georgc4/ecig-dfd-deliverable/main.tex

\documentclass[11pt]{article}
\input{preamble}

\begin{document}

% ============================================================
% COVER PAGE
% ============================================================
\begin{titlepage}
\centering
\vspace*{2cm}

{\Large\textbf{MECE E4612 --- Sustainable Manufacturing}}\\[0.5cm]
{\large Columbia University, Department of Mechanical Engineering}\\[2cm]

{\LARGE\textbf{Design for Disassembly of Disposable\\[0.3cm]
Electronic Cigarettes: A Universal Standard\\[0.3cm]
for Battery Recovery}}\\[3cm]

{\large
{Aaron Li}\\[4pt]
{Carlos Georges}\\[4pt]
{Noah Thomas}\\[4pt]
{Tony Del Vecchio}\\[2cm]
}

\authorlegend

\vfill
{\large \today}
\end{titlepage}

% ============================================================
% TABLE OF CONTENTS
% ============================================================
\tableofcontents
\newpage

% ============================================================
% REPORT BODY
% ============================================================
\input{sections/01_introduction}
\input{sections/02_materials_processes}
\input{sections/03_dfd_analysis}
\input{sections/04_lca}
\input{sections/05_alternative_concept}
\input{sections/06_results}
\input{sections/07_conclusions}

% ============================================================
% REFERENCES
% ============================================================
\newpage
\bibliographystyle{plainnat}
\bibliography{references}

\end{document}
