georgc4/ecig-dfd-deliverable/slides/outline.md

# Presentation Outline: E-Cigarette Design for Disassembly

**Constraints**: 12 slides max, 10-minute time slot + Q&A
**Tip**: ~50 seconds per slide average. Practice beforehand.

---

## Slide 1: Title Slide (~10 sec)
**Speaker**: All (introduce yourselves)

- **Title**: Design for Disassembly of Disposable Electronic Cigarettes: A Universal Standard for Battery Recovery
- **Course**: MECE E4612 — Sustainable Manufacturing
- **Team**: [Names]
- **Date**: [Presentation date]

---

## Slide 2: The E-Waste Crisis (~60 sec)
**Speaker**: Member A

**Key stats** (use large numbers, impactful visuals):
- 840 million disposable vapes discarded globally per year (5.7 per second)
- 30 tons of lithium wasted annually — enough for 3,350 EV batteries
- Batteries capable of 450+ charge cycles, used exactly once
- $95M/year in waste facility fires from lithium batteries
- 52.9% of young users throw vapes in regular trash

**Visual**: Infographic or striking photo of vape waste pile. Consider a split image: landfill of vapes vs. EV batteries that could have been made.

---

## Slide 3: Our Product (~50 sec)
**Speaker**: Member A

- Photo of the selected e-cigarette (full device)
- Brand, model, retail price, puff count
- Why this product was chosen:
  - Meets all requirements (5+ parts, 3+ materials, 2+ metals, <$20)
  - Representative of the most common disposable vape form factor
- Brief functional description (1-2 sentences)

**Visual**: High-quality product photo, front/back/side.

---

## Slide 4: Disassembly & Parts (~60 sec)
**Speaker**: Member B

- Step-by-step disassembly photos (3-4 key stages)
- Note: disassembly was destructive (cutting/prying required)
- Labeled exploded view or parts laid out on table
- Parts inventory table (7 parts with materials)

**Visual**: Photo of all parts laid out, labeled. Consider before/after disassembly comparison.

---

## Slide 5: Materials Analysis (~50 sec)
**Speaker**: Member B

- Material identification results (how each was tested)
  - Burn test, scratch test, magnet test, density, visual
- Highlight the two metallic materials: aluminum (housing) + kanthal/nichrome (coil)
- Additional metals: copper (PCB), cobalt/nickel/lithium (battery)
- Weight breakdown by part

**Visual**: Close-up photos of material tests. Table of materials + weights.

---

## Slide 6: Manufacturing Processes (~50 sec)
**Speaker**: Member B

- Focus on the 3 multi-process parts:
  1. Battery: electrode coating → cell winding → welding → wrapping
  2. Housing: extrusion → anodizing → pad printing
  3. PCB: etching → drilling → SMT → reflow solder
- Highlight that current design uses permanent joining (ultrasonic welding / adhesives)

**Visual**: Process flow diagram for each multi-process part. Simple icons or photos.

---

## Slide 7: DfD Principles Applied (~60 sec)
**Speaker**: Member C

- Top 5 DfD principles most relevant:
  1. Reversible fasteners (snap-fits replace welding)
  2. Modular architecture (3 separable modules)
  3. Hazardous components most accessible (battery first out)
  4. Material marking (ISO codes, QR for recycling)
  5. Minimize disassembly steps (1 step for battery, <5 total)
- For each: how current design VIOLATES the principle

**Visual**: Two-column layout — "Current" vs. "DfD Redesign" for each principle. Icons or simple diagrams.

---

## Slide 8: LCA — Reference Product (~50 sec)
**Speaker**: Member C

- LCA methodology summary (software, database, functional unit)
- Key results for reference product:
  - Dominant impact category
  - Dominant life cycle stage
  - Dominant SBOM input (likely battery materials)
- Stacked bar chart by life cycle stage

**Visual**: LCA results chart (stacked bar or pie by stage). Keep it clean, highlight the biggest contributor.

---

## Slide 9: The Removable Battery Standard (~60 sec)
**Speaker**: Member D

**This is the centerpiece slide — the main contribution.**

- Three standardized battery sizes (S/M/L) covering full market range
- Snap-fit battery compartment at device base
- Spring-loaded contacts, keyed orientation
- Color-coded size identification + QR code
- 1-step, tool-free battery removal
- Modular device: battery + atomizer cartridge + body

**Visual**: Exploded view CAD render or detailed diagram. Side-by-side: sealed current design vs. open DfD design with removable battery.

---

## Slide 10: LCA — DfD vs. Reference (~50 sec)
**Speaker**: Member D

- Side-by-side LCA comparison: Reference vs. DfD vs. Alternative concept
- Highlight % reduction in key impact categories
- Show effect of battery reuse (10-450 cycles) on per-device impact
- Material recovery rates: ~0% → >90%

**Visual**: Grouped bar chart comparing 3 concepts across impact categories. Use color consistently.

---

## Slide 11: Results & Discussion (~50 sec)
**Speaker**: Member D

- Disassembly time: X minutes → <30 seconds
- Material recovery: ~0% → >90%
- Fire risk: eliminated (batteries separated before disposal)
- Cost: marginal manufacturing increase offset by battery reuse savings
- Regulatory alignment: meets EU Batteries Regulation 2027 ahead of deadline
- Barriers: manufacturer adoption, consumer behavior, standardization governance

**Visual**: Summary table or dashboard-style layout with key metrics.

---

## Slide 12: Conclusions & Q&A (~30 sec + Q&A)
**Speaker**: All

- 3 key takeaways:
  1. Current disposable e-cig design is antithetical to sustainability
  2. DfD principles enable dramatic improvements with minimal design changes
  3. A universal battery standard is technically feasible and regulatory-aligned
- The EU Batteries Regulation (Feb 2027) makes this inevitable — the question is who leads
- Open for questions

**Visual**: Clean slide with 3 bullet points and "Questions?" at the bottom.

---

## General Presentation Tips

- **Font size**: Minimum 24pt for body text, 36pt+ for titles
- **Photos**: Use your OWN disassembly photos — they demonstrate hands-on work
- **Timing**: Practice to fit in 10 minutes. Each slide ~50 seconds.
- **Transitions**: Smooth handoffs between speakers. Each person covers 3 slides.
- **Member distribution**:
  - Member A: Slides 2-3 (problem + product)
  - Member B: Slides 4-6 (disassembly + materials + processes)
  - Member C: Slides 7-8 (DfD principles + reference LCA)
  - Member D: Slides 9-11 (standard + comparison LCA + results)
  - All: Slides 1, 12 (title + conclusions)
