georgc4/ecig-dfd-deliverable/figures/snapfit_cross_section.png

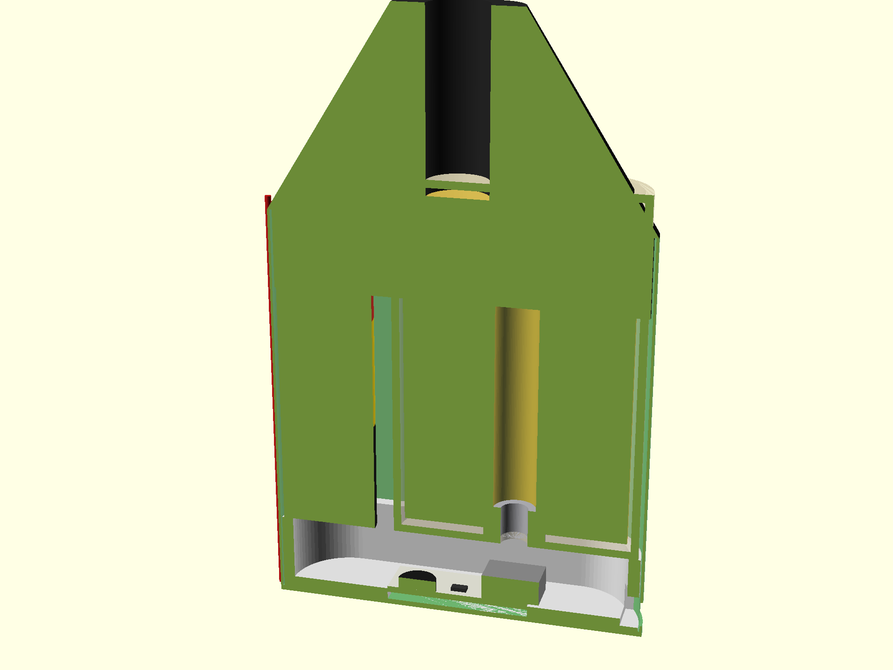
figures/snapfit_cross_section.png
