georgc4/ecig-dfd-deliverable/figures/snapfit_exploded.png

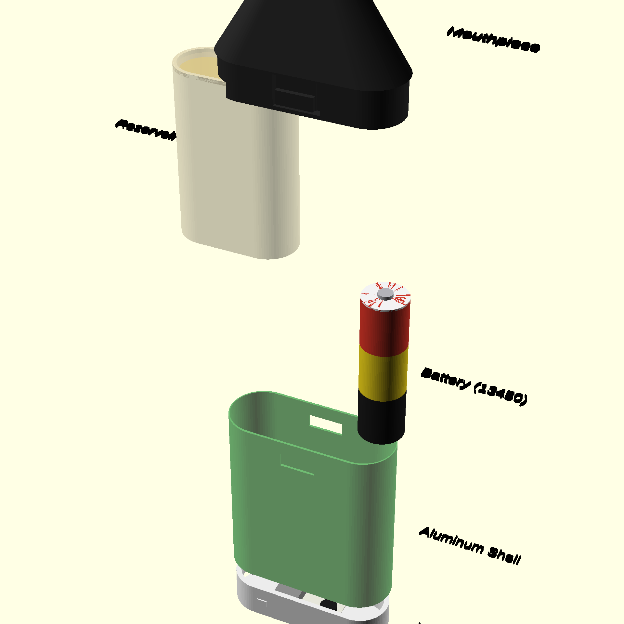
figures/snapfit_exploded.png
