georgc4/ecig-dfd-deliverable/fit.png

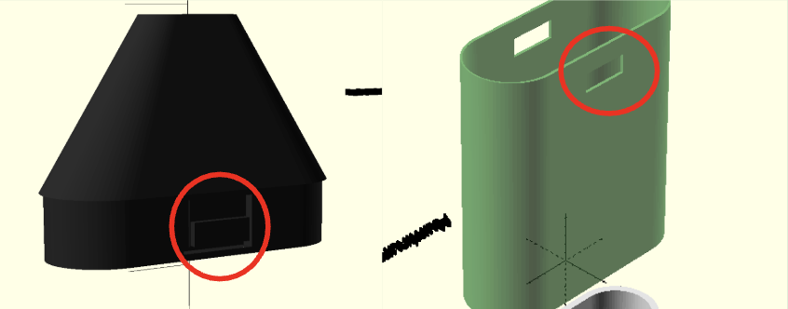
fit.png
