georgc4/ecig-dfd-deliverable/scad.png

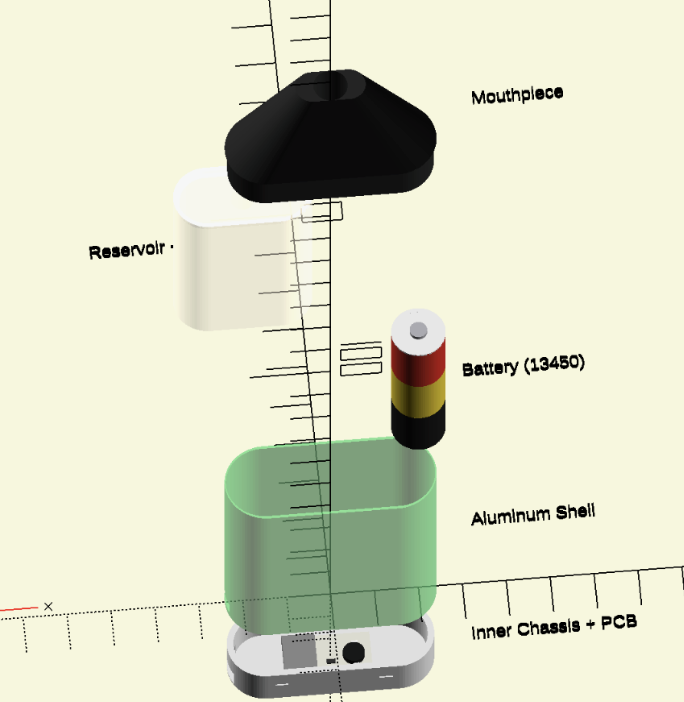
scad.png
