georgc4/ecig-dfd-deliverable/cad/assembly_preview.scad

// ============================================================================
// Air Bar NEX 3K — Faithful OpenSCAD Model
// Based on real measurements from makerspace disassembly session (3/2/26)
//
// Usage: Open in OpenSCAD -> Press F5 (preview) or F6 (render)
//        Toggle EXPLODED and CROSS_SECTION below
// ============================================================================

// === TOGGLES ================================================================
EXPLODED      = true;     // true = exploded view, false = assembled
CROSS_SECTION = false;    // true = cut away front half to see internals

$fn = 80;
GAP = EXPLODED ? 20 : 0;

// === FULL DEVICE (measured) =================================================
DEVICE_HEIGHT = 78.3;     // mm total assembled height (Z axis)
DEVICE_WIDTH  = 48.2;     // mm overall width (X axis)
DEVICE_DEPTH  = 19.0;     // mm overall thickness (Y axis)
CORNER_R      = DEVICE_DEPTH / 2;  // 9.5mm — fully rounded short ends (stadium)

// === ALUMINUM SHELL =========================================================
SHELL_WALL    = 0.7;      // mm measured wall thickness
SHELL_HEIGHT  = 52.35;    // mm exterior height (78.3 - 25.95 visible mouthpiece)
SHELL_INNER_W = 47.6;     // mm inner cavity width
SHELL_INNER_D = 17.7;     // mm inner cavity depth
SHELL_INNER_H = 50.0;     // mm inner cavity height
SHELL_INNER_R = SHELL_INNER_D / 2;  // 8.85mm

// === MOUTHPIECE =============================================================
MP_TOTAL_LEN  = 35.95;    // mm total mouthpiece length
MP_INSERT_LEN = 10.0;     // mm portion press-fitting into shell
MP_VISIBLE    = 25.95;    // mm visible above shell
MP_THICKNESS  = 7.8;      // mm tip thickness/depth
MP_TIP_WIDTH  = 16.0;     // mm tip width
MP_AIR_HOLE   = 7.8;      // mm air hole diameter
MP_RIB_THICK  = 1.0;      // mm cross-rib thickness

// === BATTERY (13450 Li-ion) =================================================
BAT_DIA       = 12.4;     // mm diameter
BAT_LEN       = 42.4;     // mm body length
BAT_NUB_DIA   = 4.0;      // mm positive terminal nub diameter
BAT_NUB_LEN   = 1.0;      // mm nub protrusion

// === PCB ====================================================================
PCB_W         = 18.6;     // mm length
PCB_D         = 11.6;     // mm width
PCB_T         = 0.84;     // mm thickness
USB_C_W       = 9.0;      // mm USB-C port width
USB_C_H       = 3.3;      // mm USB-C port height
MIC_DIA       = 5.0;      // mm MEMS microphone diameter

// === INNER CHASSIS ==========================================================
CHASSIS_WALL  = 1.5;      // mm estimated wall thickness
CHASSIS_H     = 10.0;     // mm estimated height

// === RESERVOIR / ATOMIZER ===================================================
RES_W         = 31.65;    // mm cross-section width
RES_D         = 15.64;    // mm cross-section depth
RES_H         = 46.76;    // mm height
RES_AIR_HOLE  = 3.5;      // mm central air channel
RES_WALL      = 1.0;      // mm wall thickness

// === COLORS (matching real device) ==========================================
C_SHELL       = [0.25, 0.65, 0.30, 0.75];  // Green anodized aluminum
C_MOUTHPIECE  = [0.15, 0.15, 0.15, 1.00];  // Black plastic
C_BAT_RED     = [0.80, 0.20, 0.15, 1.00];  // Red wrapper band
C_BAT_YELLOW  = [0.90, 0.80, 0.10, 1.00];  // Yellow wrapper band
C_BAT_BLACK   = [0.10, 0.10, 0.10, 1.00];  // Black wrapper band
C_BAT_NUB     = [0.70, 0.70, 0.72, 1.00];  // Silver terminal
C_PCB         = [0.90, 0.90, 0.85, 1.00];  // White PCB
C_USB         = [0.55, 0.55, 0.55, 1.00];  // Silver USB-C
C_MIC         = [0.10, 0.10, 0.10, 1.00];  // Black MEMS mic
C_LED         = [1.00, 1.00, 1.00, 1.00];  // White LED
C_CHASSIS     = [0.92, 0.92, 0.92, 1.00];  // White plastic
C_RES_SHELL   = [0.85, 0.80, 0.65, 0.45];  // Translucent reservoir
C_FOAM        = [0.90, 0.75, 0.20, 0.75];  // Yellow/amber foam
C_COIL        = [0.70, 0.70, 0.72, 1.00];  // Metal coil
C_WIRE_RED    = [0.80, 0.10, 0.10, 1.00];
C_WIRE_BLACK  = [0.10, 0.10, 0.10, 1.00];

// === DERIVED POSITIONS ======================================================
// Battery and reservoir sit side by side in the inner cavity
// Reservoir (31.65mm wide) on the left, battery (12.4mm dia) on the right
X_RES    = -(SHELL_INNER_W/2) + RES_W/2 + 0.5;    // = -7.475
X_BAT    =  (SHELL_INNER_W/2) - BAT_DIA/2 - 0.5;  // = +17.1
Z_FLOOR  = SHELL_WALL;                              // = 0.7
Z_ABOVE_CHASSIS = Z_FLOOR + CHASSIS_H;              // = 10.7

// ============================================================================
// UTILITY: Stadium / Rounded Rectangle
// ============================================================================

module stadium(w, d, h) {
    // Rounded rectangle: two semicircular ends connected by straight sides
    // w = total width (X), d = total depth (Y), h = extrusion height (Z)
    r = d / 2;
    offset_x = w/2 - r;
    hull() {
        translate([-offset_x, 0, 0]) cylinder(r=r, h=h);
        translate([ offset_x, 0, 0]) cylinder(r=r, h=h);
    }
}

// ============================================================================
// PART 1: ALUMINUM SHELL (green anodized)
// ============================================================================

module aluminum_shell() {
    color(C_SHELL)
    difference() {
        // Outer shell body
        stadium(DEVICE_WIDTH, DEVICE_DEPTH, SHELL_HEIGHT);

        // Inner cavity (open at top, closed at bottom with SHELL_WALL floor)
        translate([0, 0, SHELL_WALL])
            stadium(SHELL_INNER_W, SHELL_INNER_D, SHELL_HEIGHT);

        // USB-C port cutout (on one narrow end, near base)
        translate([-(DEVICE_WIDTH/2) - 0.1, -USB_C_W/2, 1.5])
            cube([SHELL_WALL + 0.2, USB_C_W, USB_C_H]);

        // LED windows (4 small holes flanking USB-C, on same face)
        for (y_off = [-USB_C_W/2 - 2.5, USB_C_W/2 + 1.0])
            translate([-(DEVICE_WIDTH/2) - 0.1, y_off, 2.0])
                cube([SHELL_WALL + 0.2, 1.5, 1.5]);
    }
}

// ============================================================================
// PART 2: INNER CHASSIS (white plastic frame)
// ============================================================================

module inner_chassis() {
    color(C_CHASSIS)
    difference() {
        // Outer form (matches shell inner cavity with slight clearance)
        stadium(SHELL_INNER_W - 0.4, SHELL_INNER_D - 0.4, CHASSIS_H);

        // Hollow interior (leave walls + floor)
        translate([0, 0, CHASSIS_WALL])
            stadium(SHELL_INNER_W - 0.4 - 2*CHASSIS_WALL,
                    SHELL_INNER_D - 0.4 - 2*CHASSIS_WALL,
                    CHASSIS_H);

        // PCB pocket (recessed area on bottom face, centered)
        translate([-PCB_W/2, -PCB_D/2, -0.1])
            cube([PCB_W, PCB_D, PCB_T + 0.5]);

        // USB-C pass-through hole (on narrow end)
        translate([-(SHELL_INNER_W/2), -USB_C_W/2, 0.5])
            cube([CHASSIS_WALL + 1, USB_C_W, USB_C_H + 1]);

        // Wire routing channels (grooves along inner walls)
        for (y_sign = [-1, 1])
            translate([-2, y_sign * (SHELL_INNER_D/2 - CHASSIS_WALL - 2), CHASSIS_WALL])
                cube([4, 1.5, CHASSIS_H]);
    }

    // Snap tabs on outer surface (4 small bumps for shell retention)
    color(C_CHASSIS)
    for (x = [-(SHELL_INNER_W/4), SHELL_INNER_W/4])
        for (y_sign = [-1, 1])
            translate([x - 1.5, y_sign * (SHELL_INNER_D/2 - 0.2) - 0.3, CHASSIS_H * 0.4])
                cube([3, 0.6, 2]);
}

// ============================================================================
// PART 3: PCB BOARD
// ============================================================================

module pcb_board() {
    // Main PCB substrate
    color(C_PCB)
    translate([-PCB_W/2, -PCB_D/2, 0])
        cube([PCB_W, PCB_D, PCB_T]);

    // USB-C connector (on left/negative-X short edge, protruding)
    color(C_USB)
    translate([-PCB_W/2 - 1.5, -USB_C_W/2, PCB_T])
        cube([7.5, USB_C_W, USB_C_H]);

    // MEMS microphone (right side, black cylinder)
    color(C_MIC)
    translate([PCB_W/2 - MIC_DIA/2 - 1.5, 0, PCB_T])
        cylinder(d=MIC_DIA, h=1.5);

    // 4 white SMD LEDs (2 pairs flanking USB-C and mic)
    color(C_LED)
    for (x = [-PCB_W/4 - 1, PCB_W/4 + 1])
        for (y = [-PCB_D/4, PCB_D/4])
            translate([x - 0.75, y - 0.5, PCB_T])
                cube([1.5, 1.0, 0.5]);

    // R100 resistor (small dark block)
    color([0.20, 0.20, 0.20, 1])
    translate([-1.0, -PCB_D/4 + 1, PCB_T])
        cube([2.0, 1.0, 0.5]);
}

// ============================================================================
// PART 4: BATTERY CELL (13450)
// ============================================================================

module battery_cell() {
    band = BAT_LEN / 3;

    // Black band (negative end, bottom)
    color(C_BAT_BLACK)
        cylinder(d=BAT_DIA, h=band);

    // Yellow band (middle)
    color(C_BAT_YELLOW)
    translate([0, 0, band])
        cylinder(d=BAT_DIA, h=band);

    // Red band (positive end, top)
    color(C_BAT_RED)
    translate([0, 0, 2*band])
        cylinder(d=BAT_DIA, h=band);

    // Positive terminal nub
    color(C_BAT_NUB)
    translate([0, 0, BAT_LEN])
        cylinder(d=BAT_NUB_DIA, h=BAT_NUB_LEN);

    // White insulator ring at positive end
    color([0.95, 0.95, 0.95, 1])
    translate([0, 0, BAT_LEN - 0.5])
        difference() {
            cylinder(d=BAT_DIA, h=0.5);
            cylinder(d=BAT_DIA - 2, h=0.6);
        }
}

// ============================================================================
// PART 5: RESERVOIR / ATOMIZER ASSEMBLY
// ============================================================================

module reservoir_atomizer() {
    res_inner_w = RES_W - 2*RES_WALL;
    res_inner_d = RES_D - 2*RES_WALL;

    // Translucent outer shell
    color(C_RES_SHELL)
    difference() {
        stadium(RES_W, RES_D, RES_H);

        // Hollow interior
        translate([0, 0, RES_WALL])
            stadium(res_inner_w, res_inner_d, RES_H);

        // Air channel through entire height
        translate([0, 0, -0.1])
            cylinder(d=RES_AIR_HOLE, h=RES_H + 0.2);
    }

    // Internal foam/wick material (visible through translucent walls)
    color(C_FOAM)
    difference() {
        translate([0, 0, RES_WALL + 1])
            stadium(res_inner_w - 1, res_inner_d - 1, RES_H - 2*RES_WALL - 2);

        // Air channel through foam
        translate([0, 0, -0.1])
            cylinder(d=RES_AIR_HOLE + 2, h=RES_H + 0.2);
    }

    // Coil element at bottom (metal ring around air channel)
    color(C_COIL)
    translate([0, 0, 1])
        difference() {
            cylinder(d=8, h=4);
            cylinder(d=RES_AIR_HOLE, h=4.1);
        }

    // Top cap (sealed end)
    color(C_RES_SHELL)
    translate([0, 0, RES_H - RES_WALL])
        stadium(RES_W, RES_D, RES_WALL);
}

// ============================================================================
// PART 6: MOUTHPIECE (black plastic)
// ============================================================================

module mouthpiece() {
    color(C_MOUTHPIECE)
    difference() {
        union() {
            // Insert portion (extends downward, fits inside shell opening)
            translate([0, 0, -MP_INSERT_LEN])
                stadium(SHELL_INNER_W - 0.6, SHELL_INNER_D - 0.6, MP_INSERT_LEN);

            // Visible tapered body: from shell-width at base to tip dimensions at top
            hull() {
                // Base footprint (at shell top level)
                stadium(DEVICE_WIDTH, DEVICE_DEPTH, 0.01);

                // Tip footprint
                translate([0, 0, MP_VISIBLE])
                    stadium(MP_TIP_WIDTH, MP_THICKNESS, 0.01);
            }
        }

        // Air hole through entire mouthpiece
        translate([0, 0, -MP_INSERT_LEN - 0.1])
            cylinder(d=MP_AIR_HOLE, h=MP_TOTAL_LEN + 0.2);
    }

    // Cross-shaped internal ribs inside the air channel (insert portion)
    color(C_MOUTHPIECE)
    translate([0, 0, -MP_INSERT_LEN]) {
        // X-direction rib
        translate([-MP_AIR_HOLE/2, -MP_RIB_THICK/2, 0])
            cube([MP_AIR_HOLE, MP_RIB_THICK, MP_INSERT_LEN]);
        // Y-direction rib
        translate([-MP_RIB_THICK/2, -MP_AIR_HOLE/2, 0])
            cube([MP_RIB_THICK, MP_AIR_HOLE, MP_INSERT_LEN]);
    }
}

// ============================================================================
// PART 7: WIRES (red + black, battery to PCB)
// ============================================================================

module wires(bat_x, wire_len) {
    // Red wire (positive, from battery top, routes down)
    color(C_WIRE_RED)
    translate([bat_x + BAT_DIA/2 + 1.0, -1, 0])
        cylinder(d=0.8, h=wire_len);

    // Black wire (negative, from battery bottom, routes down)
    color(C_WIRE_BLACK)
    translate([bat_x + BAT_DIA/2 + 2.5, 1, 0])
        cylinder(d=0.8, h=wire_len);
}

// ============================================================================
// ASSEMBLY
// ============================================================================

module full_assembly() {

    // === ASSEMBLED POSITIONS (Z=0 at shell base) ===
    z_shell      = 0;
    z_chassis    = Z_FLOOR;                      // 0.7
    z_pcb        = Z_FLOOR + 1.0;                // PCB sits in chassis pocket
    z_internals  = Z_ABOVE_CHASSIS;              // 10.7 (battery + reservoir base)
    z_mouthpiece = SHELL_HEIGHT;                 // 52.35

    // === EXPLODED OFFSETS ===
    // Vertical explosion: parts stack upward with gaps
    ez_shell     = 0;
    ez_chassis   = EXPLODED ? -(CHASSIS_H + GAP) : z_chassis;
    ez_pcb       = EXPLODED ? -(CHASSIS_H + GAP) + 1.0 : z_pcb;
    ez_battery   = EXPLODED ? SHELL_HEIGHT + GAP : z_internals;
    ez_reservoir = EXPLODED ? SHELL_HEIGHT + GAP*2 + BAT_LEN + BAT_NUB_LEN : z_internals;
    ez_mouthpiece= EXPLODED ? SHELL_HEIGHT + GAP*3 + BAT_LEN + BAT_NUB_LEN + RES_H : z_mouthpiece;

    // Lateral offsets for exploded view
    ex_battery   = EXPLODED ? 20 : X_BAT;
    ex_reservoir = EXPLODED ? -20 : X_RES;

    // ── Aluminum Shell ──
    translate([0, 0, ez_shell])
        aluminum_shell();

    // ── Inner Chassis ──
    translate([0, 0, ez_chassis])
        inner_chassis();

    // ── PCB Board ──
    translate([0, 0, ez_pcb])
        pcb_board();

    // ── Battery Cell ──
    translate([ex_battery, 0, ez_battery])
        battery_cell();

    // ── Reservoir + Atomizer ──
    translate([ex_reservoir, 0, ez_reservoir])
        reservoir_atomizer();

    // ── Mouthpiece ──
    translate([0, 0, ez_mouthpiece])
        mouthpiece();

    // ── Wires (assembled view only) ──
    if (!EXPLODED) {
        translate([0, 0, Z_FLOOR])
            wires(X_BAT, Z_ABOVE_CHASSIS + BAT_LEN);
    }
}

// ============================================================================
// RENDER
// ============================================================================

if (CROSS_SECTION) {
    difference() {
        full_assembly();
        // Cut away front half (+Y) to reveal internals
        translate([-DEVICE_WIDTH, 0, -50])
            cube([DEVICE_WIDTH * 2, DEVICE_DEPTH, DEVICE_HEIGHT + 200]);
    }
} else {
    full_assembly();
}

// ── Exploded View Labels ────────────────────────────────────────────────────
if (EXPLODED) {
    label_x = DEVICE_WIDTH/2 + 8;

    color("black") {
        translate([label_x, 0, SHELL_HEIGHT/2])
            text("Aluminum Shell", size=3, halign="left");

        translate([label_x, 0, -(CHASSIS_H + GAP) + CHASSIS_H/2])
            text("Inner Chassis + PCB", size=3, halign="left");

        translate([30, 0, SHELL_HEIGHT + GAP + BAT_LEN/2])
            text("Battery (13450)", size=3, halign="left");

        translate([-55, 0, SHELL_HEIGHT + GAP*2 + BAT_LEN + BAT_NUB_LEN + RES_H/2])
            text("Reservoir + Atomizer", size=3, halign="left");

        translate([label_x, 0, SHELL_HEIGHT + GAP*3 + BAT_LEN + BAT_NUB_LEN + RES_H + MP_VISIBLE/2])
            text("Mouthpiece", size=3, halign="left");
    }
}
