georgc4/ecig-dfd-deliverable/(list of files, cad)

Other CAD files:
cad/assembly_snapfit.scad
