georgc4/ecig-dfd-deliverable/3_2_26_makerspace_session_results/Air_bar_msrmnts_1.rtf

Here's your measurement checklist. Record everything in mm and grams.

Full Device (before disassembly)
# | Measurement | Value

1 | Overall length | _78.3__ mm
2 | Overall width/diameter (widest point) | 48.2___ mm
3 | Overall depth/thickness (if not round) | _19.0__ mm
4 | Total weight | 52___ g
5 | Cross-section shape (circle / rectangle / rounded rect?) | Rounded rect_______

35.95___ mm. : mouthpiece length part that presses into body: 10mm

6 | Mouthpiece length | Mouthpiece: thickness 7.8mm
7 | Mouthpiece tip outer diameter | 16___ mm
8 | Mouthpiece air hole diameter (look into it) | 7.8___ mm

Disassembly — Document As You Go
# | Observation | Notes

9 | How is it sealed? (press-fit / glued / welded / crimped) | Pressfit_______
10 | Tools needed to open | Xacto knife to separate mouthpiece from body_______
11 | Time to open (stopwatch it) | 4-5___ min to successfully separate battery from device
12 | Steps to reach battery (count each distinct action) | _about 10__ steps
13 | Was anything destroyed during opening? (Y/N, describe) | __yes_____
14 | Take photos at each disassembly step | done? Y

Battery Cell
# | Measurement | Value

15 | Diameter | __12.4_ mm
16 | Length (body only, without terminal nub) | 42.4___ mm
17 | Length (including positive terminal nub) | ___ mm
18 | Terminal nub diameter | ___ mm
19 | Terminal nub height | ___ mm
20 | Weight | _12__ g
21 | Shape (cylindrical / pouch / prismatic?) | ___cylinder____
22 | Any wrapper/sleeve? (color, material) | _______
23 | Any markings? (capacity mAh, voltage, chemistry, mfr) | 13450 3.7v 2.405 Wh 650mAh_______
24 | How was it connected? (spot-welded tabs / soldered wires / spring contacts) | Soldered wires directly to pcb_______
25 | Connection tab/wire dimensions (width x thickness if tabs) | ___ mm

Housing / Shell
# | Measurement | Value

26 | Material (aluminum / plastic / mixed?) | aluminum_______
27 | Wall thickness (measure at cut edge) | 0.7___ mm
28 | Inner cavity diameter/width | 17.7x47.6___ mm
29 | Inner cavity length (full internal space) | ~50___ mm
30 | Housing weight (empty, no internals) | 13___ g
31 | Any material markings / recycling symbols? | N/a just branding_______

PCB / Electronics
# | Measurement | Value

32 | PCB length | __18.6_ mm
33 | PCB width | 11.6___ mm
34 | PCB thickness | 0.84___ mm
35 | PCB weight | __2_ g
36 | How is PCB mounted? (press-fit / glued / friction) | ___pressfit with snapping tabs____
37 | Has USB-C or charging port? (Y/N) | y_______
38 | Charging port dimensions (if present) | Standard usbc___ x ___ mm
39 | LED present? (Y/N, size, color) | _y, 2 pairs of white leds______
40 | Activation method (draw-activated / button?) | Draw activated, microphone present on pcb_______

Atomizer / Coil / Reservoir
# | Measurement | Value

41 | Reservoir + atomizer combined length | _46.76mm__ mm
42 | Reservoir + atomizer combined diameter | 31.65x15.64, rounded rect___ mm
43 | Reservoir + atomizer combined weight | 10___ g
44 | Is atomizer separable from reservoir? (Y/N) | y_______
45 | Coil connection type (soldered / press-fit / tabs) | Shoved into juice foam_______
46 | E-liquid remaining? (dry / some / full) | some_______

Repeat with Second Device
# | Item | Device 1 | Device 2 | Delta

47 | Battery diameter | ___ | ___ | ___
48 | Battery length | ___ | ___ | ___
49 | Battery weight | ___ | ___ | ___
50 | Housing wall thickness | ___ | ___ | ___
51 | Total device weight | ___ | ___ | ___
This confirms manufacturing consistency and tells us how tight our tolerances can be.

What to Bring Back / Save
• The battery cells (we need these for fit testing the 3D print)
• The PCB (for sizing the bracket)
• Photos of every step
• This checklist filled in
When you're done, give me the battery diameter and length and I'll update config.py and the OpenSCAD file immediately.
