georgc4/ecig-dfd-deliverable/figures/makerspace/IMG_6130.png

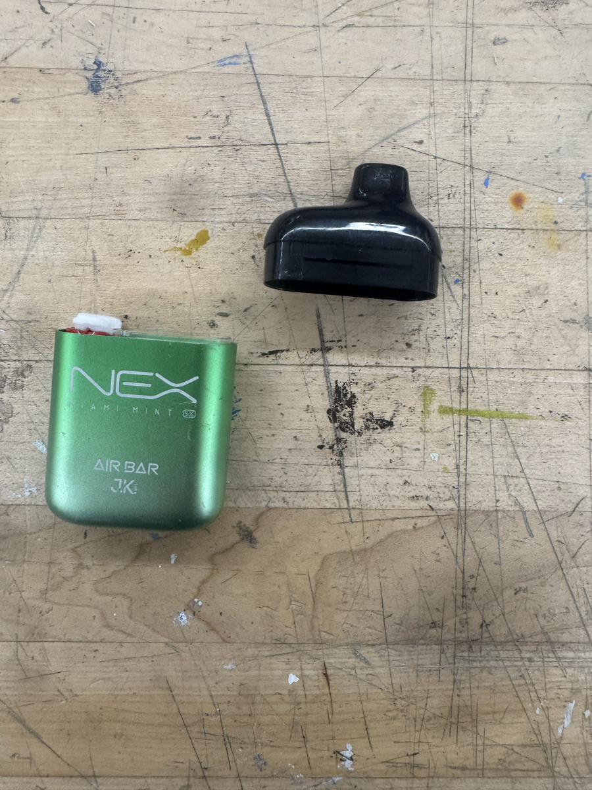
figures/makerspace/IMG_6130.png
