georgc4/ecig-dfd-deliverable/figures/makerspace/IMG_6131.png

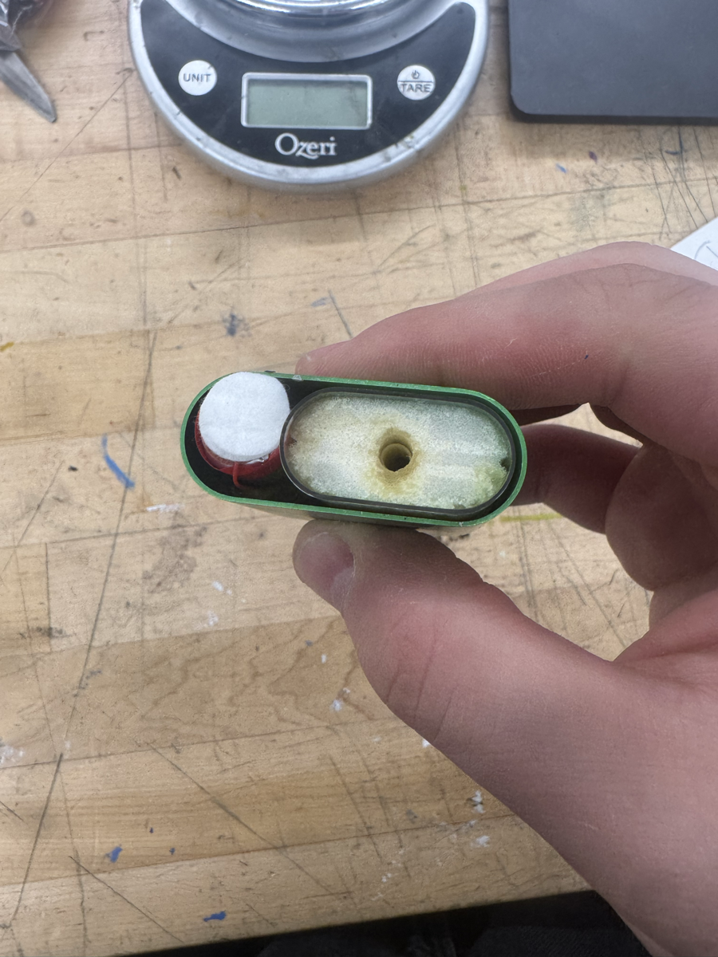
figures/makerspace/IMG_6131.png
