georgc4/ecig-dfd-deliverable/figures/makerspace/IMG_6132.png

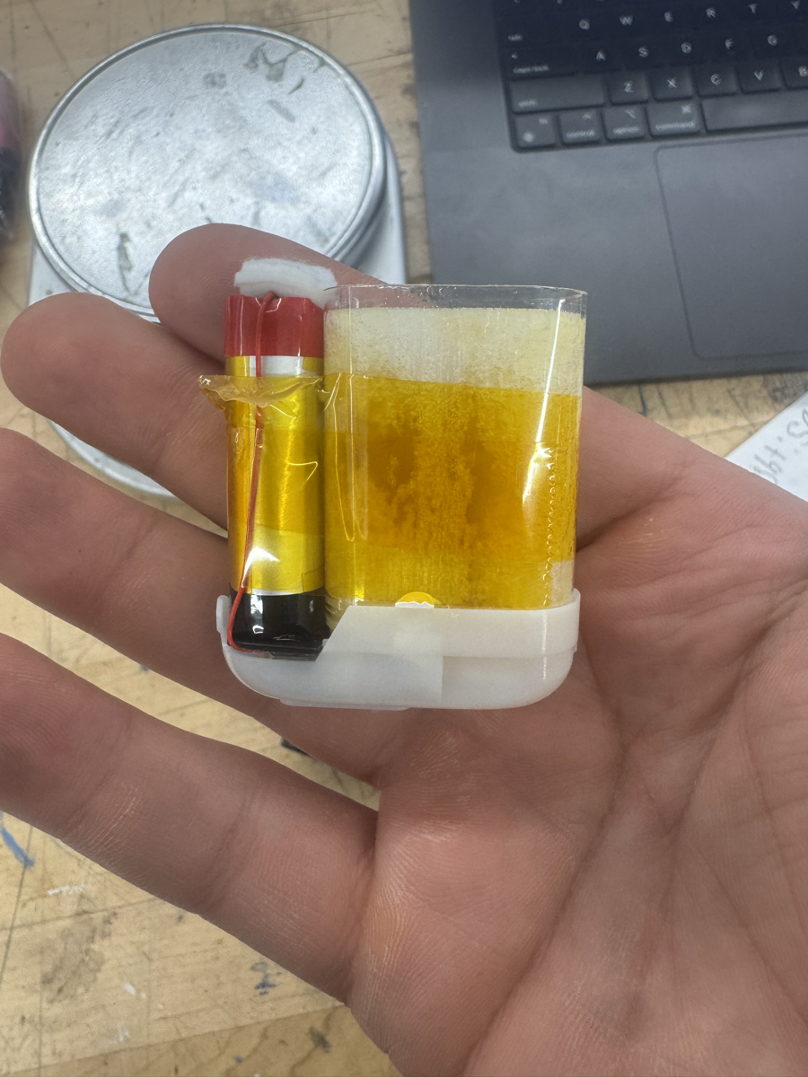
figures/makerspace/IMG_6132.png
