georgc4/ecig-dfd-deliverable/figures/makerspace/IMG_6133.png

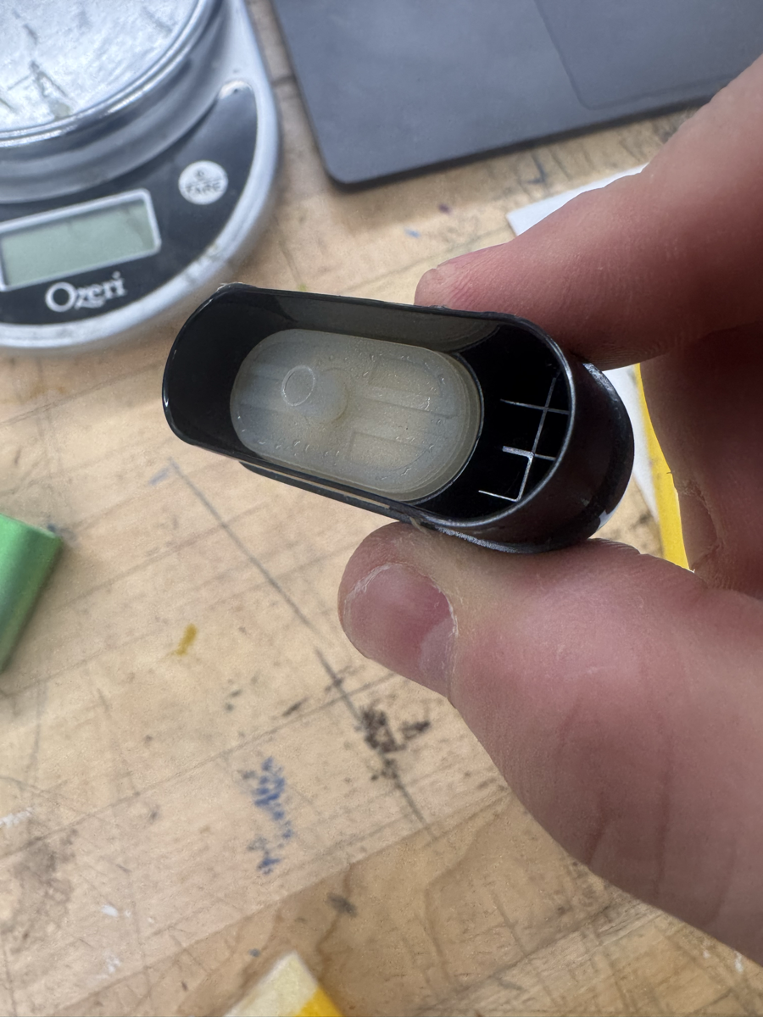
figures/makerspace/IMG_6133.png
