georgc4/ecig-dfd-deliverable/figures/makerspace/IMG_6136.png

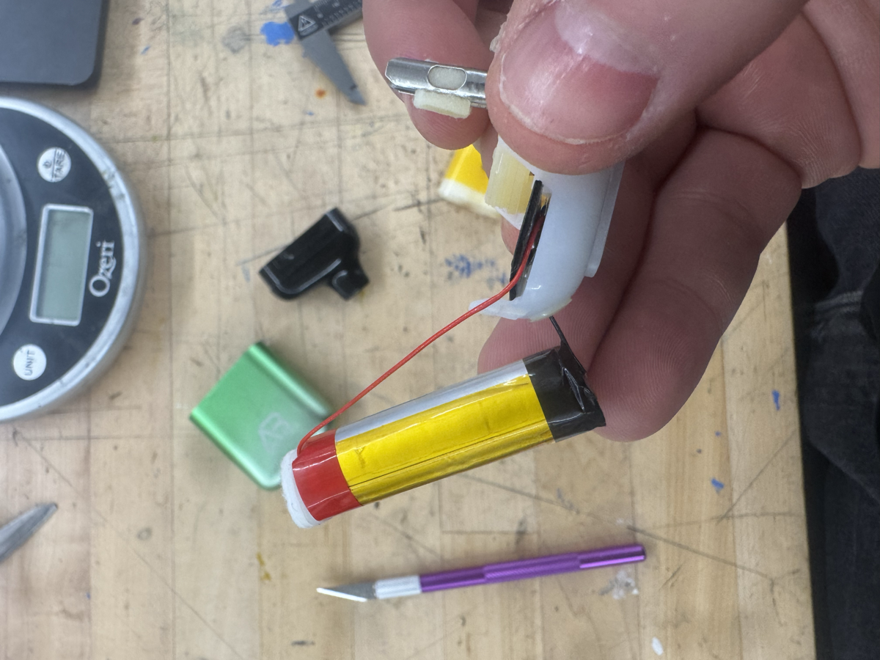
figures/makerspace/IMG_6136.png
