georgc4/ecig-dfd-deliverable/figures/makerspace/IMG_6138.png

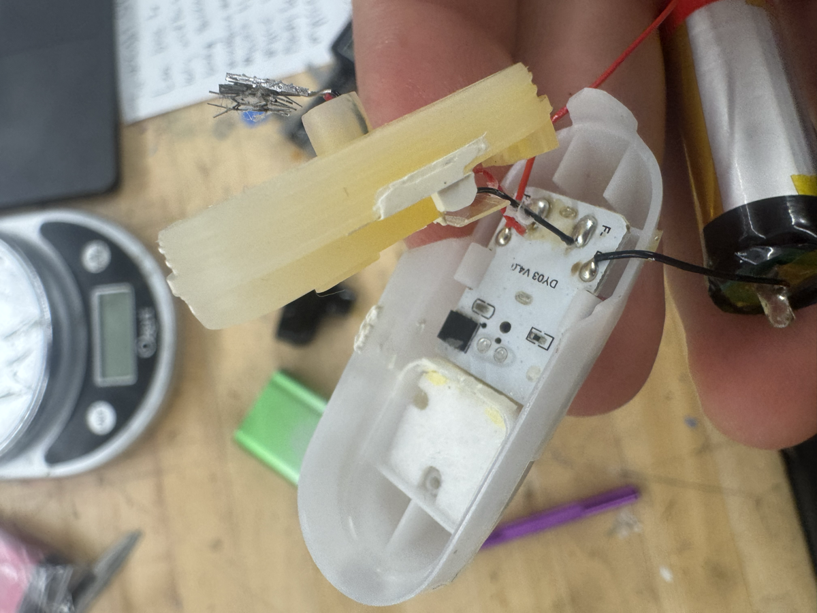
figures/makerspace/IMG_6138.png
