georgc4/ecig-dfd-deliverable/figures/makerspace/IMG_6139.png

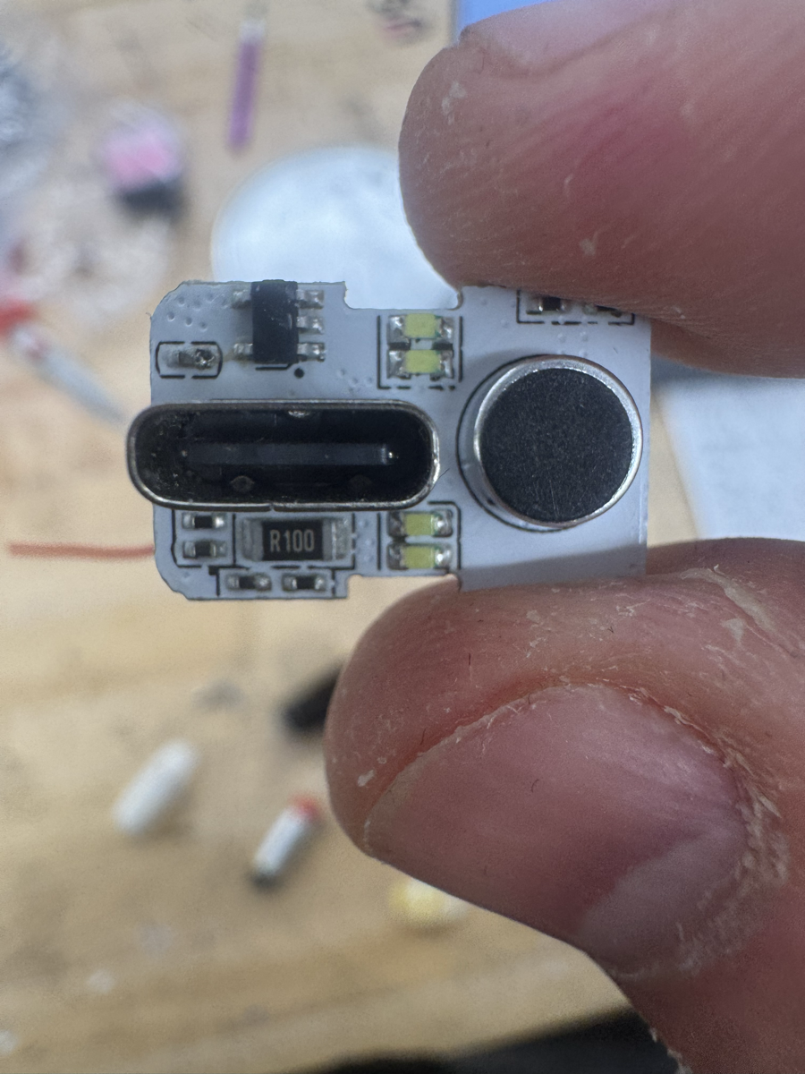
figures/makerspace/IMG_6139.png
