georgc4/ecig-dfd-deliverable/figures/makerspace/IMG_6141.png

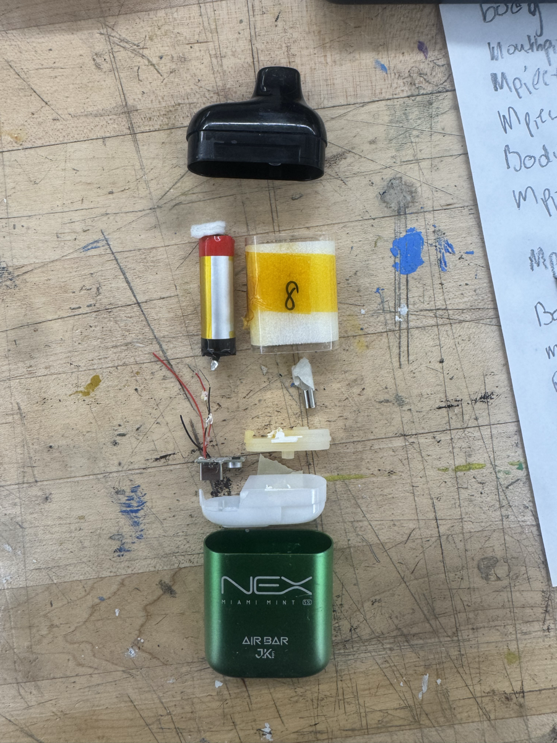
figures/makerspace/IMG_6141.png
