georgc4/ecig-dfd-deliverable/figures/makerspace/IMG_6143.png

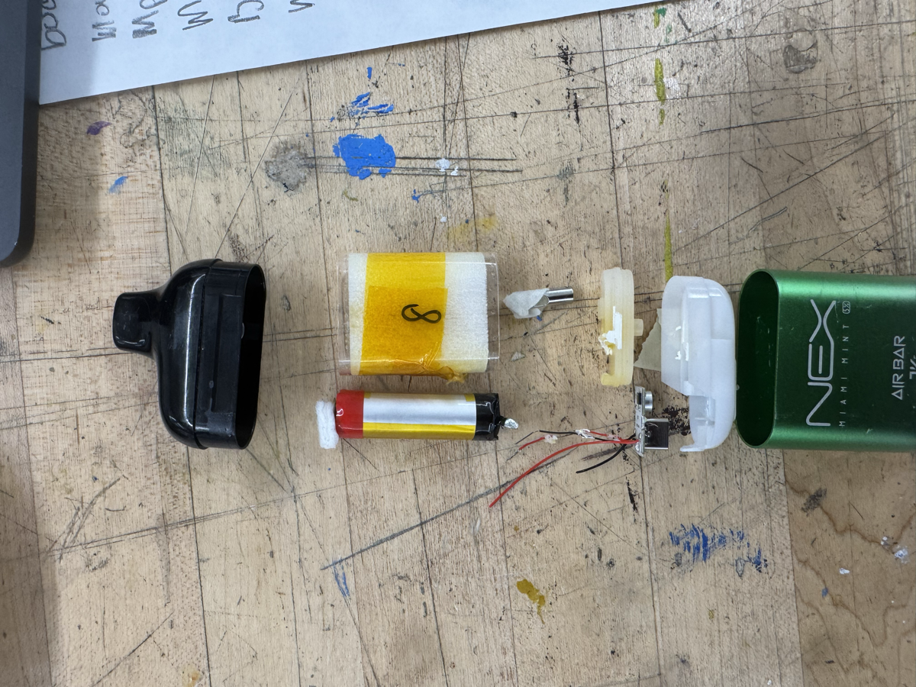
figures/makerspace/IMG_6143.png
