georgc4/ecig-dfd-deliverable/figures/makerspace/IMG_6144.png

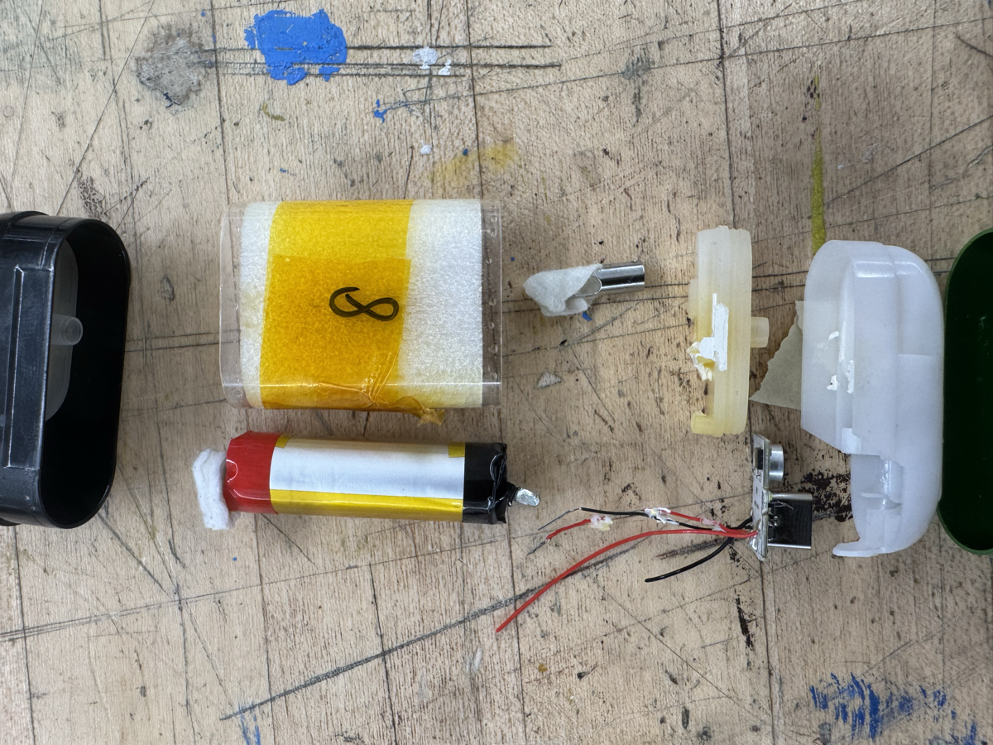
figures/makerspace/IMG_6144.png
