georgc4/ecig-dfd-deliverable/figures/snapfit_assembled.png

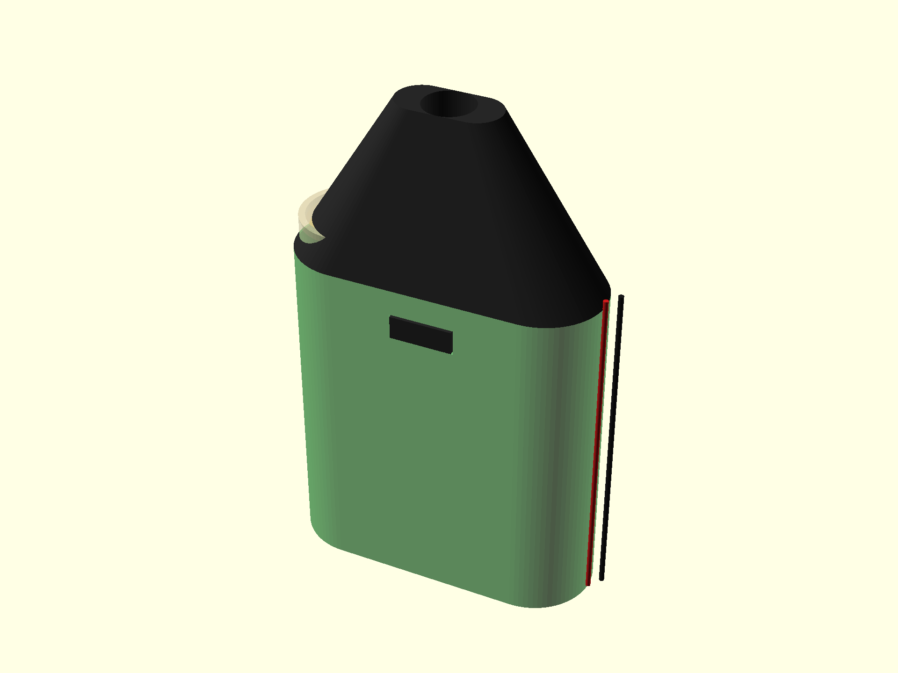
figures/snapfit_assembled.png
