georgc4/ecig-dfd-deliverable/(commit log)

2026-03-12 Initial Overleaf Import
    [assembly_preview.scad]
2026-03-12 Merge local work with Overleaf teammate changes
    Section 1: Added both product images (presentation + makerspace disassembly)
    Section 2: Fixed disassembly time to 10-15 min, added makerspace photos
    Section 3: Added Noah's snap-fit and disassembly images, fixed table time
    Section 4: Kept as-is (Aaron's)
    Section 5: Full rewrite — reframed around aluminum impact (per LCA),
    added OpenSCAD snap-fit CAD renders, push-button tab design details
    Section 6: Filled LCA table with actual Sustainable Minds data (30→18 mPts),
    fixed disassembly times, kept Tony's discussion text
    Section 7: Kept Tony's findings text, completed finding 4 with LCA data,
    fixed cut-off limitations, kept teammates' futu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
    [assembly_snapfit.scad]
2026-03-12 Polish sections 5 and 6: add author credit, remove cross-section fig, humanize writing
    - Add Carlos Georges credit to Section 5 and 6 headers
    - Remove superfluous figure 2 (housing/mouthpiece separation) from intro
    - Remove cross-section figure from Section 5 (didn't show internals well)
    - Resolve remaining \todo{} markers in Section 2
    - Humanize writing in Sections 5 and 6: replace em dashes, soften AI patterns,
    use first-person where appropriate
    - Re-render exploded view with better camera settings (GAP=6, centered)
    - Recompile PDF (31 pages, 0 errors)
